won98/cocktailmaker/계획서 및 보고서.pdf

R

E | 제어공학응용및실험 작품계획서
P | 블루투스를 이용한 칵테일 제조기
O
RT

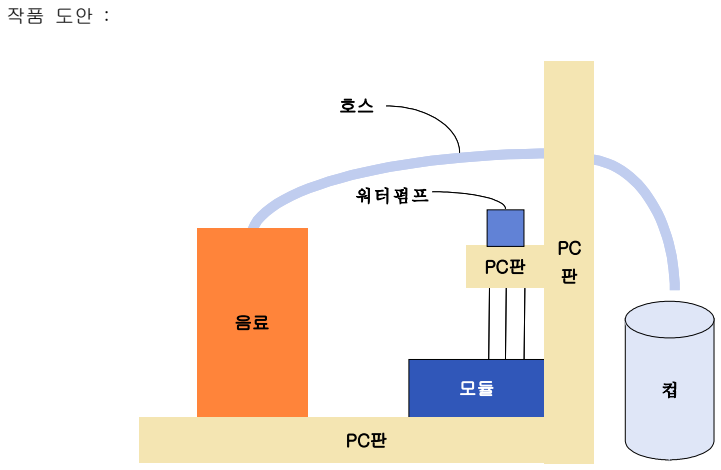
[picture p1: figure]
PC판; 워터펌프

과 | 목 | : | 제어공학응용및실험
학 | 번 | : | 201920251, 201720650, 201720668
학 | 과 | : | 제어계측공학전공
성 | 명 | : | 함주희, 서상원, 서정무
제 출 일 자 : | 2021. 12. 7
담 당 교 수 : | 이봉섭 교수님

# 작품계획서

## 작품명 : 블루투스를 이용한 자동 칵테일 제조기

개발동기 및 목적 : 현재 코로나 19로 인한 공공시설 이용에 있어서 사람들은 접촉을 최소화하려 한다. 예를 들어

음료수 기기에서 음료를 내릴 때 손으로 눌러서 조작해야 하거나 칵테일을 제조하는 데 있어서 음료를 골라가면서 한 번에 하나씩 담아야 하는 번거로움이 있다. 시중에 나와 있는 정수기나 음 료 기기를 어떻게 하면 이보다 더 편리하게 조작할 수 있을까 방법을 찾다가 블루투스를 이용한 자동 칵테일 제조기를 생각하게 되었다. 작품 구성 : 워터펌프(12V) 4개, PC(폴리카보네이트)판, 아두이노 우노, 실리콘호스(6*9mm), 릴

레이모듈 (4구×), 블루투스 모듈(HC-05), SMPS(12V), 가정용 케이블(220V), 점퍼선, 브레드보 드, 저항(Ω×), 커패시터(×)

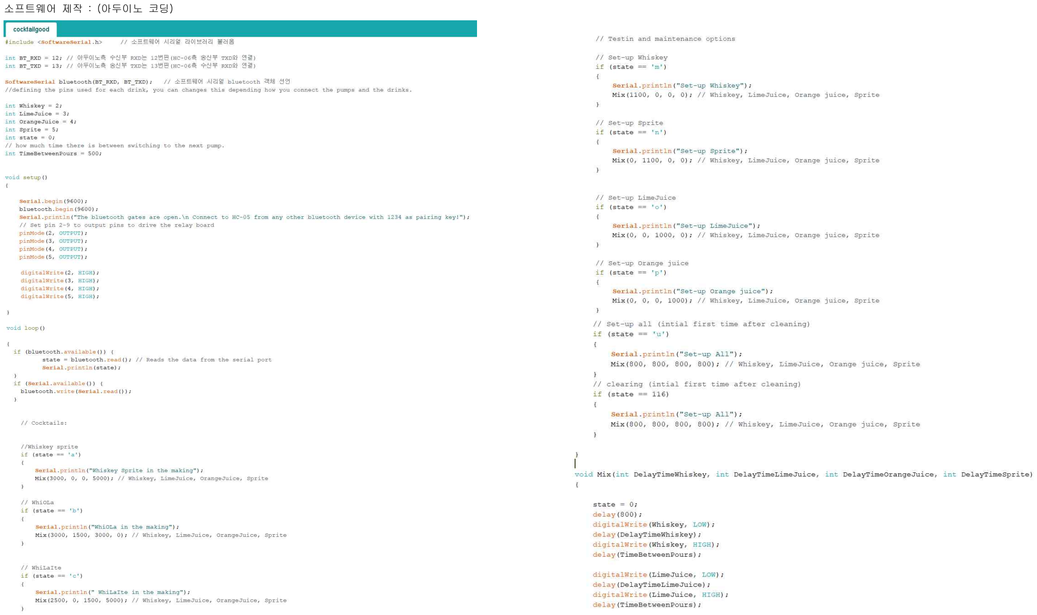
[picture p2: page 2]

소프트웨어 제작 : (아두이노 코딩)

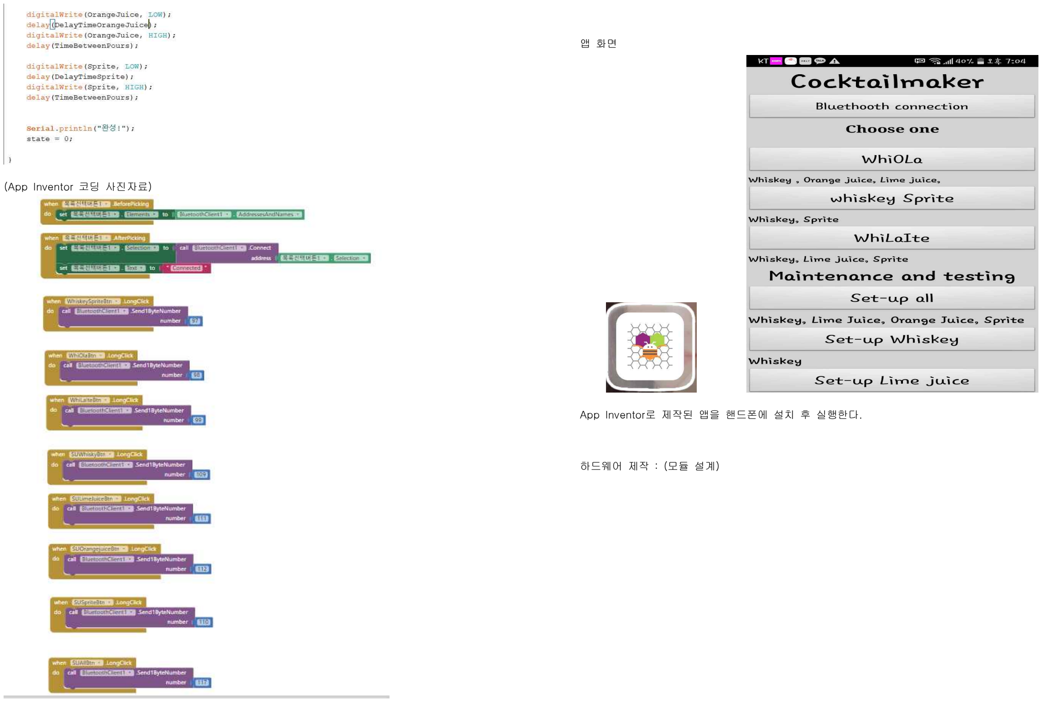
[picture p3: page 3]

(App Inventor 코딩 사진자료)

앱 화면

App Inventor로 제작된 앱을 핸드폰에 설치 후 실행한다. 하드웨어 제작 : (모듈 설계)

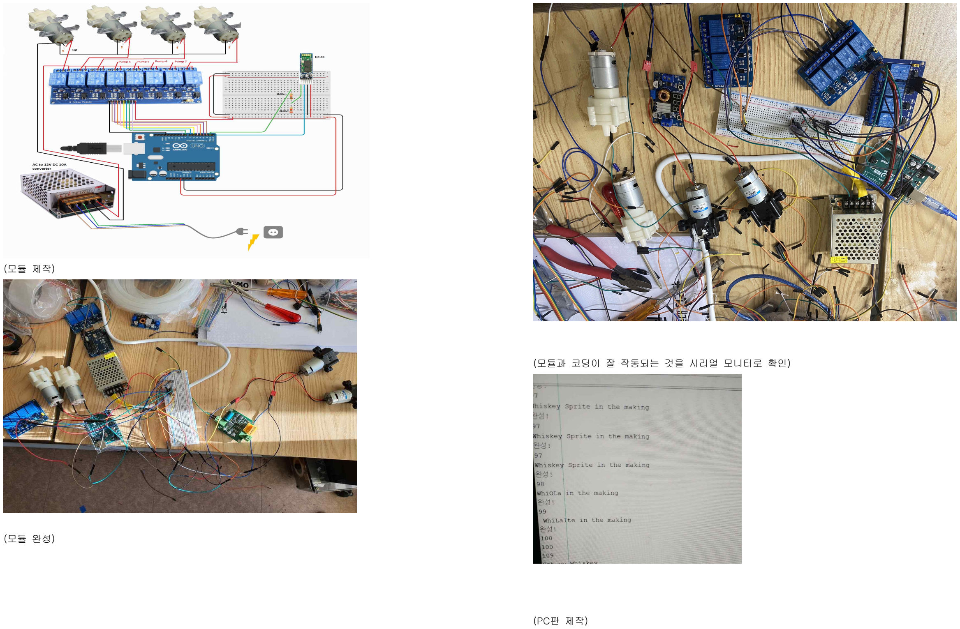
[picture p4: page 4]

(모듈 제작)

(모듈 완성)

(모듈과 코딩이 잘 작동되는 것을 시리얼 모니터로 확인)

(PC판 제작)

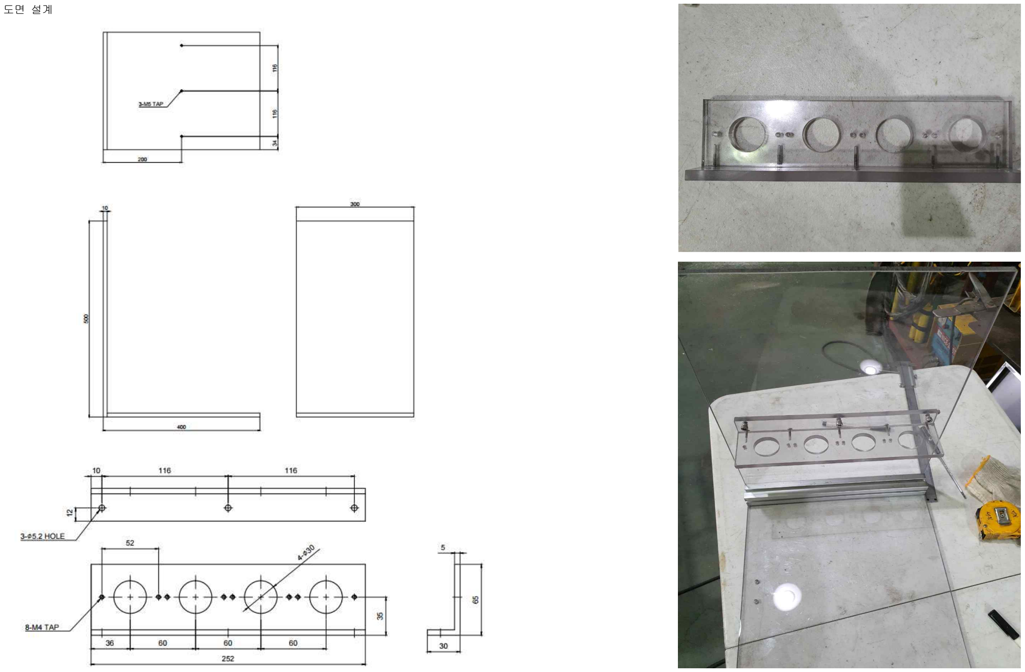
[picture p5: page 5]

도면 설계

작품 완성 사진

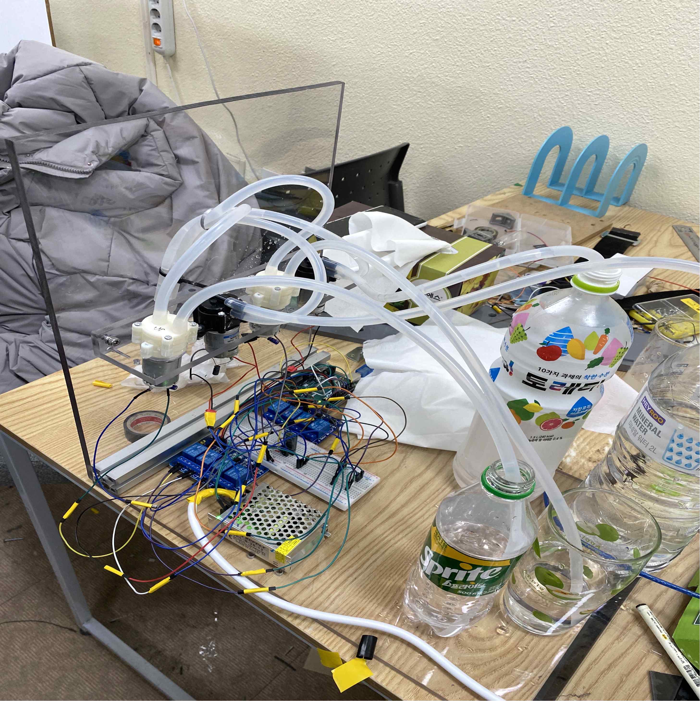
[picture p6: figure]

기대효과 : 스마트폰 터치만으로 칵테일이 제조되도록 블루투스 모듈을 이용하여 스마트폰 앱을 통해 원하

는 칵테일을 선택해 제조할 수 있다. 또, 원하는 음료 종류와 섞는 비율을 다르게 해 다양한 조 합의 음료를 설계하여 터치 조작만으로 여러 종류의 음료를 만들 수 있다. 그리고 음료를 받을 때 손으로 눌러서 조작하지 않아도 자동으로 시간 텀을 두고 음료가 나오기 때문에 간편하며 위 생에 신경도 쓸 수 있다. 시행착오 : 1) 회로를 설계하면서 릴레이를 이용하여 가정용 220V를 12V로 출력을 바꿀 수 있는 SMPS를

사용하는 방법을 인터넷 자료들을 찾아보며 익혔지만, SMPS와 릴레이를 연결하는 부분에서 릴

레이가 제대로 작동하지 않았다. 하지만 많은 시간을 들여서 아두이노 모듈 회로 수정을 거듭한 결과, 다행히 릴레이 모듈이 정상적으로 잘 작동하였다. 2) 아두이노 블루투스 모듈과 App Inventor로 만든 앱이 제대로 연동이 되지 않은 경우가 잦았

다. 이러한 오류를 해결하기 위해 많은 시행착오를 겪은 끝에 블루투스 모듈 연결에 문제가 있었 다는 것을 알게 되었다. 회로를 설계하면서 블루투스 모듈의 TXD 핀과 RXD 핀을 헷갈리다 보니 블루투스와 앱이 서로 값을 전달하고 받지 못하는 결과를 초래하였다. 따라서 아두이노 블루투스 코딩 영상과 사용 방법을 유튜브를 통해 재차 익힌 후, 핀을 제대로 연결하여 문제를 해결하였 다. 3) 아두이노 회로를 설계하면서 연결한 선이 자주 빠지고, 워터 펌프의 고장을 막기 위해 커패시

터를 펌프에 달아놓는 과정에서 납땜한 선이 끊어지는 상황이 다수 발생하였다. 이를 해결하기 위해 절연 테이프를 감아 연결한 선을 고정시켰고, 납땜 과정에서 워터 펌프의 선이 끊어지지 않 도록 섬세하게 작업하였다. 4) 아두이노 코딩에서 시리얼 모니터에 값이 출력되지 않는 경우가 발생하였다. 유튜브에 있는

아두이노 블루투스 모듈 제어 영상을 공부하면서 아두이노 코딩에서 시리얼 모니터에서 입력하 는 값과 블루투스에서 입력하는 값을 받기 위한 함수를 제대로 선언하지 않았다는 것을 깨달았 고, 이후 수정하여 시리얼 모니터에 입력값에 따른 올바른 출력값을 얻을 수 있었다. 참고자료 링크 : https://youtu.be/7ztbMLb_dS4, https://youtu.be/bJWsax6M8ro, https://youtu.be/VJnPI4l74Sg

https://youtu.be/YJd_QDB992E
